kaminaris/GigaPyron/3DModels/DG25S-BarrierTerminal_7.62mm v7.step

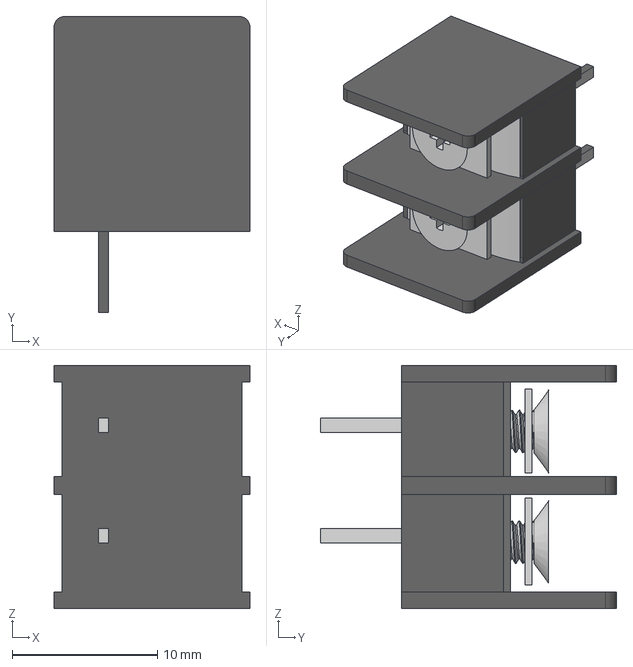
[picture p1: CAD file, 2026-10-02]
3DModels/DG25S-BarrierTerminal_7.62mm v7.step
13.5 x 20.4 x 16.7 mm
M3 SCRew x 2
