kaminaris/GigaPyron/3DModels/Heatsink_TO220_5P.step

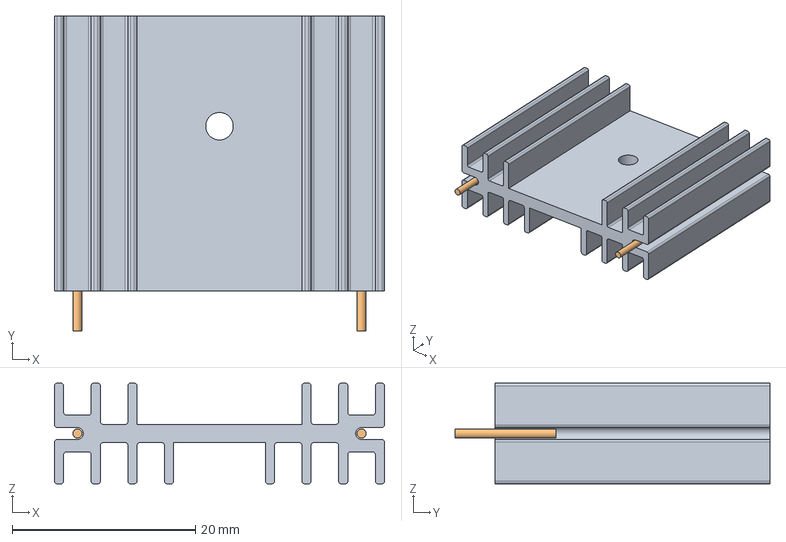
[picture p2: CAD file, 2026-10-02]
3DModels/Heatsink_TO220_5P.step
36.0 x 34.3 x 11.0 mm
disipador
pin x 2
