kaminaris/GigaPyron/3DModels/DISIPADOR_TO220_5P.STEP

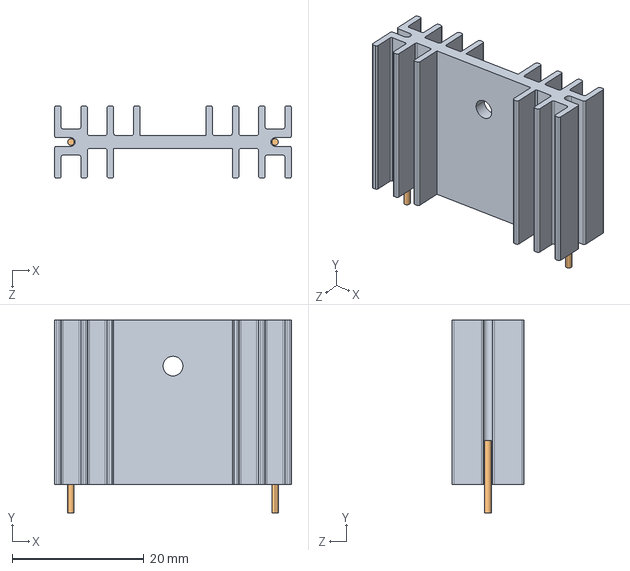
[picture p3: CAD file, 2026-10-02]
3DModels/DISIPADOR_TO220_5P.STEP
36.0 x 29.3 x 11.0 mm
disipador
pin x 2
