kaminaris/GigaPyron/AIFryer.kicad_pcb

## KiCad design AIFryer.kicad_pcb (2026-10-04)

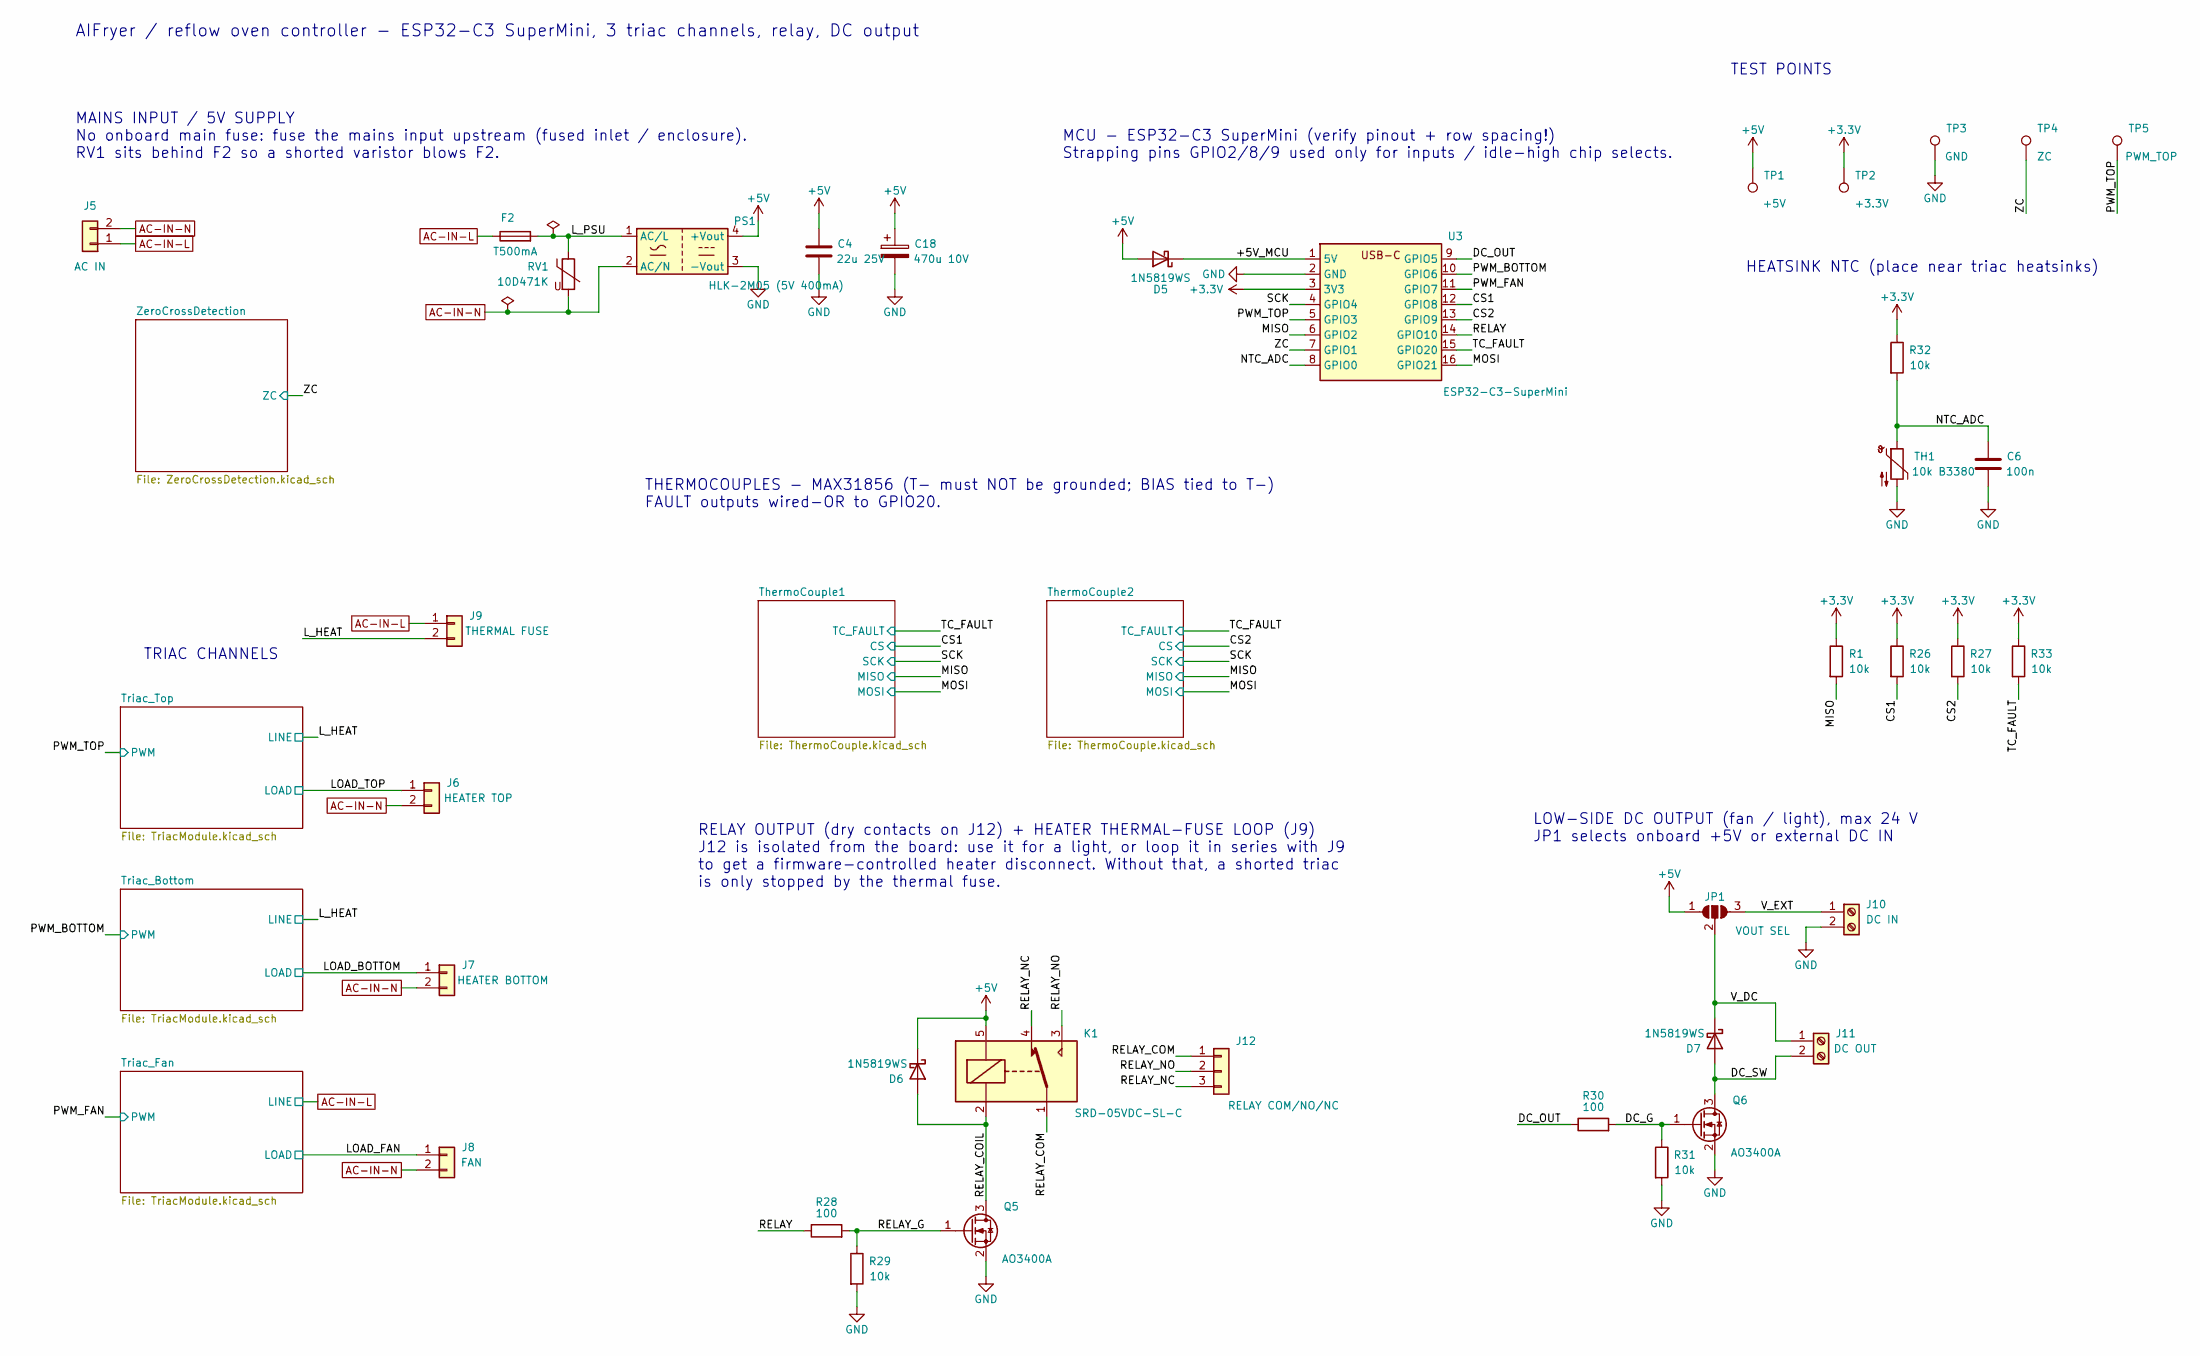
[picture p4: schematic AIFryer.kicad_sch, AIFryer - Reflow Oven Controller]

Parts:
C4: 22u 25V; C_1206_3216Metric; MPN C12891
C6: 100n; C_0603_1608Metric; MPN C14663
C18: 470u 10V; CP_Elec_6.3x7.7; MPN C55388431
D5, D6, D7: 1N5819WS; D_SOD-323; MPN C191023
F2: T500mA; Fuse_Littelfuse_372_D8.50mm; MPN C529783
J5: AC IN; TerminalBlock_Phoenix_PT-1,5-2-5.0-H_1x02_P5.00mm_Horizontal; MPN C5188434
J6: HEATER TOP; TerminalBlock_Phoenix_PT-1,5-2-5.0-H_1x02_P5.00mm_Horizontal; MPN C5188434
J7: HEATER BOTTOM; TerminalBlock_Phoenix_PT-1,5-2-5.0-H_1x02_P5.00mm_Horizontal; MPN C5188434
J8: FAN; TerminalBlock_Phoenix_PT-1,5-2-5.0-H_1x02_P5.00mm_Horizontal; MPN C5188434
J9: THERMAL FUSE; TerminalBlock_Phoenix_PT-1,5-2-5.0-H_1x02_P5.00mm_Horizontal; MPN C5188434
J10: DC IN; TerminalBlock_Phoenix_PT-1,5-2-3.5-H_1x02_P3.50mm_Horizontal; MPN C695629
J11: DC OUT; TerminalBlock_Phoenix_PT-1,5-2-3.5-H_1x02_P3.50mm_Horizontal; MPN C695629
J12: RELAY COM/NO/NC; TerminalBlock_Phoenix_PT-1,5-3-5.0-H_1x03_P5.00mm_Horizontal; MPN C5188435
JP1: VOUT SEL; SolderJumper-3_P1.3mm_Open_RoundedPad1.0x1.5mm
K1: SRD-05VDC-SL-C; Relay_SPDT_SANYOU_SRD_Series_Form_C; MPN C35449
PS1: HLK-2M05 (5V 400mA); Converter_ACDC_Hi-Link_HLK-2Mxx; MPN C209909
Q5, Q6: AO3400A; SOT-23; MPN C20917
R1, R26, R27, R29, R31, R32, R33: 10k; R_0603_1608Metric; MPN C25804
R28, R30: 100; R_0603_1608Metric; MPN C22775
RV1: 10D471K; RV_Disc_D12mm_W4.2mm_P7.5mm; MPN C8760
TH1: 10k B3380; R_0603_1608Metric; MPN C13564
TP1: +5V; TestPoint_THTPad_D1.5mm_Drill0.7mm
TP2: +3.3V; TestPoint_THTPad_D1.5mm_Drill0.7mm
TP3: GND; TestPoint_THTPad_D1.5mm_Drill0.7mm
TP4: ZC; TestPoint_THTPad_D1.5mm_Drill0.7mm
TP5: PWM_TOP; TestPoint_THTPad_D1.5mm_Drill0.7mm
U3: ESP32-C3-SuperMini

Connections:
+3.3V: R1.1, R26.1, R27.1, R32.1, R33.1, TP2.1 (1_1), U3.3 (3V3); also elsewhere on the board
+5V: C4.1, C18.1, D5.2 (A), D6.1 (K), JP1.1 (A), K1.5, PS1.4 (+Vout), TP1.1 (1_1)
/+5V_MCU: D5.1 (K), U3.1 (5V)
/CS1: R26.2, U3.12 (GPIO8); also elsewhere on the board
/CS2: R27.2, U3.13 (GPIO9); also elsewhere on the board
/DC_G: Q6.1 (G), R30.2, R31.1
/DC_OUT: R30.1, U3.9 (GPIO5)
/DC_SW: D7.2 (A), J11.2, Q6.3 (D)
/LOAD_BOTTOM: J7.1; also elsewhere on the board
/LOAD_FAN: J8.1; also elsewhere on the board
/LOAD_TOP: J6.1; also elsewhere on the board
/L_HEAT: J9.2; also elsewhere on the board
/L_PSU: F2.2, PS1.1 (AC/L), RV1.1
/MISO: R1.2, U3.6 (GPIO2); also elsewhere on the board
/MOSI: U3.16 (GPIO21); also elsewhere on the board
/NTC_ADC: C6.1, R32.2, TH1.1, U3.8 (GPIO0)
/PWM_BOTTOM: U3.10 (GPIO6); also elsewhere on the board
/PWM_FAN: U3.11 (GPIO7); also elsewhere on the board
/PWM_TOP: TP5.1 (1_1), U3.5 (GPIO3); also elsewhere on the board
/RELAY: R28.1, U3.14 (GPIO10)
/RELAY_COIL: D6.2 (A), K1.2, Q5.3 (D)
/RELAY_COM: J12.1, K1.1
/RELAY_G: Q5.1 (G), R28.2, R29.1
/RELAY_NC: J12.3, K1.4
/RELAY_NO: J12.2, K1.3
/SCK: U3.4 (GPIO4); also elsewhere on the board
/TC_FAULT: R33.2, U3.15 (GPIO20); also elsewhere on the board
/V_DC: D7.1 (K), J11.1, JP1.2 (C)
/V_EXT: J10.1, JP1.3 (B)
/ZC: TP4.1 (1_1), U3.7 (GPIO1); also elsewhere on the board
AC-IN-L: F2.1, J5.1, J9.1; also elsewhere on the board
AC-IN-N: J5.2, J6.2, J7.2, J8.2, PS1.2 (AC/N), RV1.2; also elsewhere on the board
GND: C4.2, C6.2, C18.2, J10.2, PS1.3 (-Vout), Q5.2 (S), Q6.2 (S), R29.2, R31.2, TH1.2, TP3.1 (1_1), U3.2 (GND); also elsewhere on the board

Notes on the sheet:
TRIAC CHANNELS
THERMOCOUPLES - MAX31856 (T- must NOT be grounded; BIAS tied to T-) FAULT outputs wired-OR to GPIO20.
MAINS INPUT / 5V SUPPLY No onboard main fuse: fuse the mains input upstream (fused inlet / enclosure). RV1 sits behind F2 so a shorted varistor blows F2.
HEATSINK NTC (place near triac heatsinks)
MCU - ESP32-C3 SuperMini (verify pinout + row spacing!) Strapping pins GPIO2/8/9 used only for inputs / idle-high chip selects.
AIFryer / reflow oven controller - ESP32-C3 SuperMini, 3 triac channels, relay, DC output
RELAY OUTPUT (dry contacts on J12) + HEATER THERMAL-FUSE LOOP (J9) J12 is isolated from the board: use it for a light, or loop it in series with J9 to get a firmware-controlled heater disconnect. Without that, a shorted triac is only stopped by the thermal fuse.
TEST POINTS
LOW-SIDE DC OUTPUT (fan / light), max 24 V JP1 selects onboard +5V or external DC IN

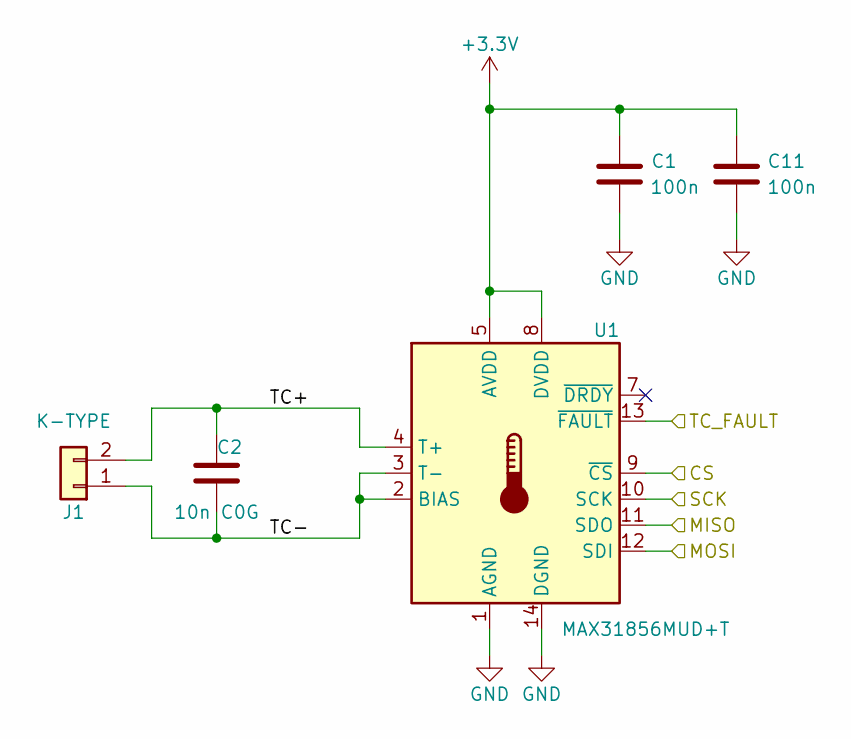
[picture p5: schematic ThermoCouple.kicad_sch, AIFryer - Thermocouple Input]

Parts:
C1, C11: 100n; C_0603_1608Metric; MPN C14663
C2: 10n C0G; C_0603_1608Metric; MPN C22399611
J1: K-TYPE; PhoenixContact_GMSTBA_2,5_2-G-7,62_1x02_P7.62mm_Horizontal; MPN C395930
U1: MAX31856MUD+T; TSSOP-14_4.4x5mm_P0.65mm; MPN C2653162

Connections:
+3.3V: C1.1, C11.1, U1.5 (AVDD), U1.8 (DVDD); also elsewhere on the board
/CS1: U1.9 (~CS); also elsewhere on the board
/MISO: U1.11 (SDO); also elsewhere on the board
/MOSI: U1.12 (SDI); also elsewhere on the board
/SCK: U1.10 (SCK); also elsewhere on the board
/TC_FAULT: U1.13 (~FAULT); also elsewhere on the board
/ThermoCouple1/TC+: C2.1, J1.2, U1.4 (T+)
/ThermoCouple1/TC-: C2.2, J1.1, U1.2 (BIAS), U1.3 (T-)
GND: C1.2, C11.2, U1.1 (AGND), U1.14 (DGND); also elsewhere on the board

Parts of its further copies:
C3: 10n C0G; C_0603_1608Metric; MPN C22399611
C5, C12: 100n; C_0603_1608Metric; MPN C14663
J2: K-TYPE; PhoenixContact_GMSTBA_2,5_2-G-7,62_1x02_P7.62mm_Horizontal; MPN C395930
U2: MAX31856MUD+T; TSSOP-14_4.4x5mm_P0.65mm; MPN C2653162

Connections of its further copies:
+3.3V: C5.1, C12.1, U2.5 (AVDD), U2.8 (DVDD); also elsewhere on the board
/CS2: U2.9 (~CS); also elsewhere on the board
/MISO: U2.11 (SDO); also elsewhere on the board
/MOSI: U2.12 (SDI); also elsewhere on the board
/SCK: U2.10 (SCK); also elsewhere on the board
/TC_FAULT: U2.13 (~FAULT); also elsewhere on the board
/ThermoCouple2/TC+: C3.1, J2.2, U2.4 (T+)
/ThermoCouple2/TC-: C3.2, J2.1, U2.2 (BIAS), U2.3 (T-)
GND: C5.2, C12.2, U2.1 (AGND), U2.14 (DGND); also elsewhere on the board

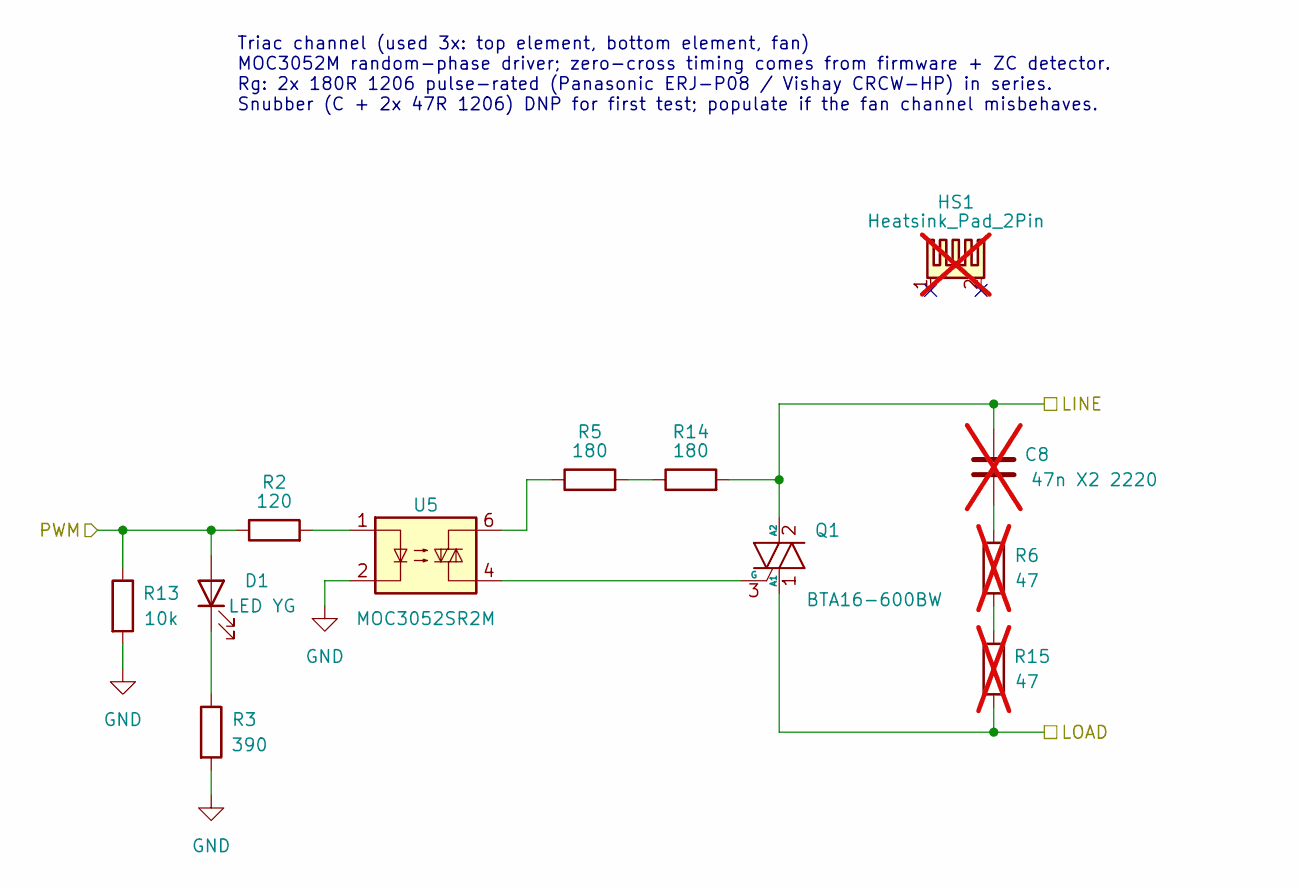
[picture p6: schematic TriacModule.kicad_sch, AIFryer - Triac Channel]

Parts:
C8: 47n X2 2220; C_2220_5750Metric; MPN C5331998; not fitted
D1: LED YG; LED_0603_1608Metric; MPN C2987554
HS1: Heatsink_Pad_2Pin; Heatsink36x11; not fitted
Q1: BTA16-600BW; TO-220-3_Horizontal_TabUp; MPN C87396
R2: 120; R_0603_1608Metric; MPN C22787
R3: 390; R_0603_1608Metric; MPN C23151
R5, R14: 180; R_1206_3216Metric; MPN C20166761
R6, R15: 47; R_1206_3216Metric; not fitted
R13: 10k; R_0603_1608Metric; MPN C25804
U5: MOC3052SR2M; SMDIP-6_W9.53mm; MPN C19864

Connections:
/LOAD_TOP: Q1.1 (A1), R15.2; also elsewhere on the board
/L_HEAT: C8.1, Q1.2 (A2), R14.2; also elsewhere on the board
/PWM_TOP: D1.2 (A), R2.1, R13.1; also elsewhere on the board
GND: R3.2, R13.2, U5.2; also elsewhere on the board
unnamed: C8.2, R6.1
unnamed: D1.1 (K), R3.1
unnamed: Q1.3 (G), U5.4
unnamed: R2.2, U5.1
unnamed: R5.1, U5.6
unnamed: R5.2, R14.1
unnamed: R6.2, R15.1

Parts of its further copies:
C9, C10: 47n X2 2220; C_2220_5750Metric; MPN C5331998; not fitted
D3, D4: LED YG; LED_0603_1608Metric; MPN C2987554
Q2, Q4: BTA16-600BW; TO-220-3_Horizontal_TabUp; MPN C87396
R4, R20: 390; R_0603_1608Metric; MPN C23151
R8, R21: 120; R_0603_1608Metric; MPN C22787
R11, R17, R22, R23: 180; R_1206_3216Metric; MPN C20166761
R12, R18, R24, R25: 47; R_1206_3216Metric; not fitted
R16, R19: 10k; R_0603_1608Metric; MPN C25804
U7, U8: MOC3052SR2M; SMDIP-6_W9.53mm; MPN C19864

Connections of its further copies:
/LOAD_BOTTOM: Q2.1 (A1), R18.2; also elsewhere on the board
/LOAD_FAN: Q4.1 (A1), R25.2; also elsewhere on the board
/L_HEAT: C9.1, Q2.2 (A2), R17.2; also elsewhere on the board
/PWM_BOTTOM: D3.2 (A), R8.1, R16.1; also elsewhere on the board
/PWM_FAN: D4.2 (A), R19.1, R21.1; also elsewhere on the board
AC-IN-L: C10.1, Q4.2 (A2), R23.2; also elsewhere on the board
GND: R4.2, R16.2, R19.2, R20.2, U7.2, U8.2; also elsewhere on the board
unnamed: C9.2, R12.1
unnamed: C10.2, R24.1
unnamed: D3.1 (K), R4.1
unnamed: D4.1 (K), R20.1
unnamed: Q2.3 (G), U7.4
unnamed: Q4.3 (G), U8.4
unnamed: R8.2, U7.1
unnamed: R11.1, U7.6
unnamed: R11.2, R17.1
unnamed: R12.2, R18.1
unnamed: R21.2, U8.1
unnamed: R22.1, U8.6
unnamed: R22.2, R23.1
unnamed: R24.2, R25.1

Notes on the sheet:
Triac channel (used 3x: top element, bottom element, fan) MOC3052M random-phase driver; zero-cross timing comes from firmware + ZC detector. Rg: 2x 180R 1206 pulse-rated (Panasonic ERJ-P08 / Vishay CRCW-HP) in series. Snubber (C + 2x 47R 1206) DNP for first test; populate if the fan channel misbeha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

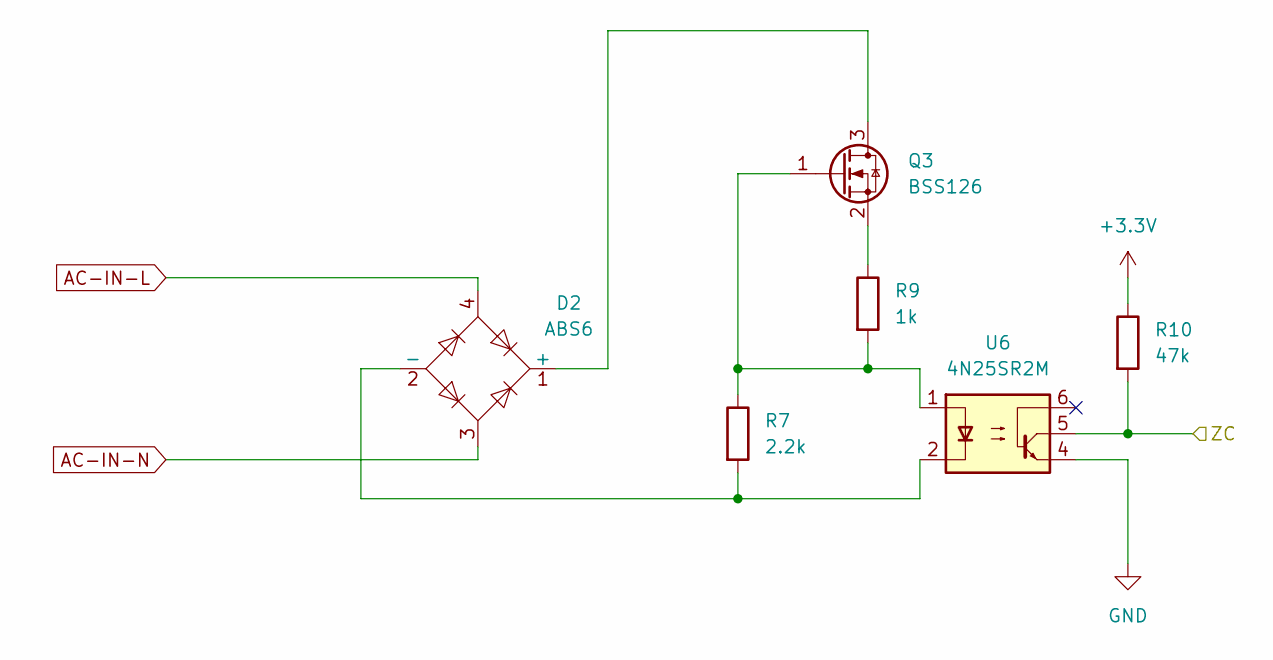
[picture p7: schematic ZeroCrossDetection.kicad_sch, AIFryer - Zero-Cross Detector]

Parts:
D2: ABS6; Diode_Bridge_Diotec_ABS; MPN C54444726
Q3: BSS126; SOT-23; MPN C2987085; JLCRotOffset 0
R7: 2.2k; R_0603_1608Metric; MPN C4190
R9: 1k; R_0603_1608Metric; MPN C21190
R10: 47k; R_0603_1608Metric; MPN C25819
U6: 4N25SR2M; SMDIP-6_W9.53mm; MPN C44165

Connections:
+3.3V: R10.1; also elsewhere on the board
/ZC: R10.2, U6.5; also elsewhere on the board
AC-IN-L: D2.4; also elsewhere on the board
AC-IN-N: D2.3; also elsewhere on the board
GND: U6.4; also elsewhere on the board
unnamed: D2.1 (+), Q3.3 (D)
unnamed: D2.2 (-), R7.2, U6.2
unnamed: Q3.1 (G), R7.1, R9.2, U6.1
unnamed: Q3.2 (S), R9.1

Board: 2 copper layers, 86 parts (19 on the bottom side), 62 nets, no tracks yet.
